spacelab-ufsc/S-band-transmitter/README.md

<h1 align="center">
	TRANSMITTER FOR S-BAND
	<br>
</h1>

<h4 align="center">Transmitter module designed to operate on S-band</h4>

<p align="center">
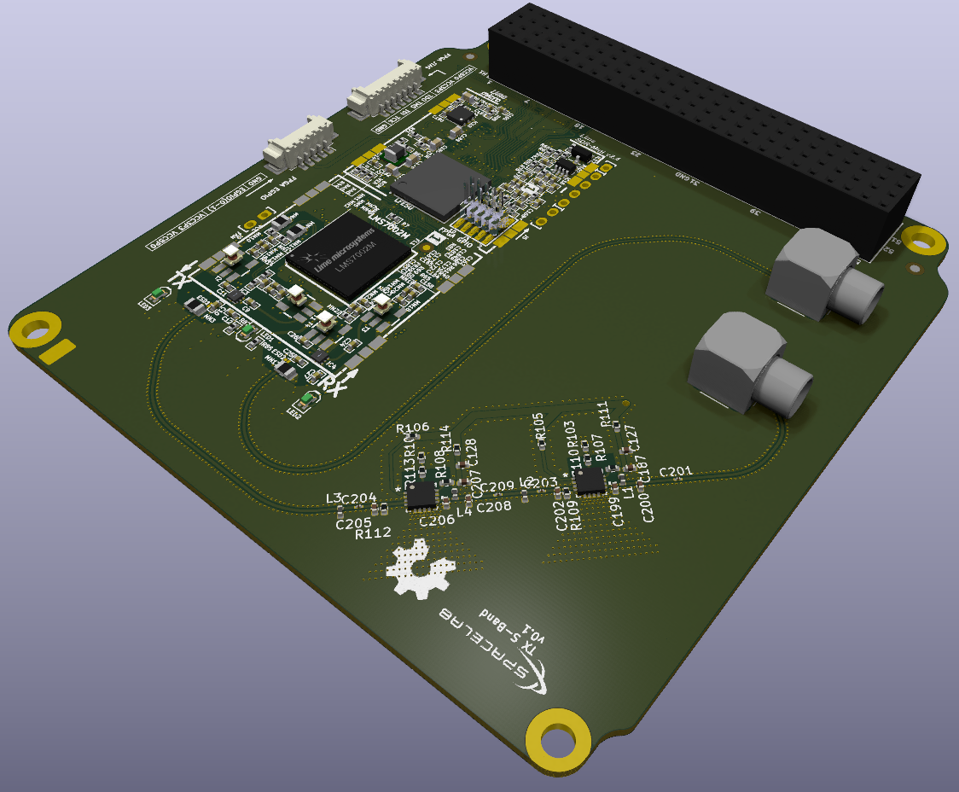
[picture p1: doc/figures/sband-board-3d-model.png]
    
</p>
