spacelab-ufsc/S-band-transmitter/hardware/sband_transmitter.kicad_pcb

## KiCad design hardware/sband_transmitter.kicad_pcb (2026-11-09)

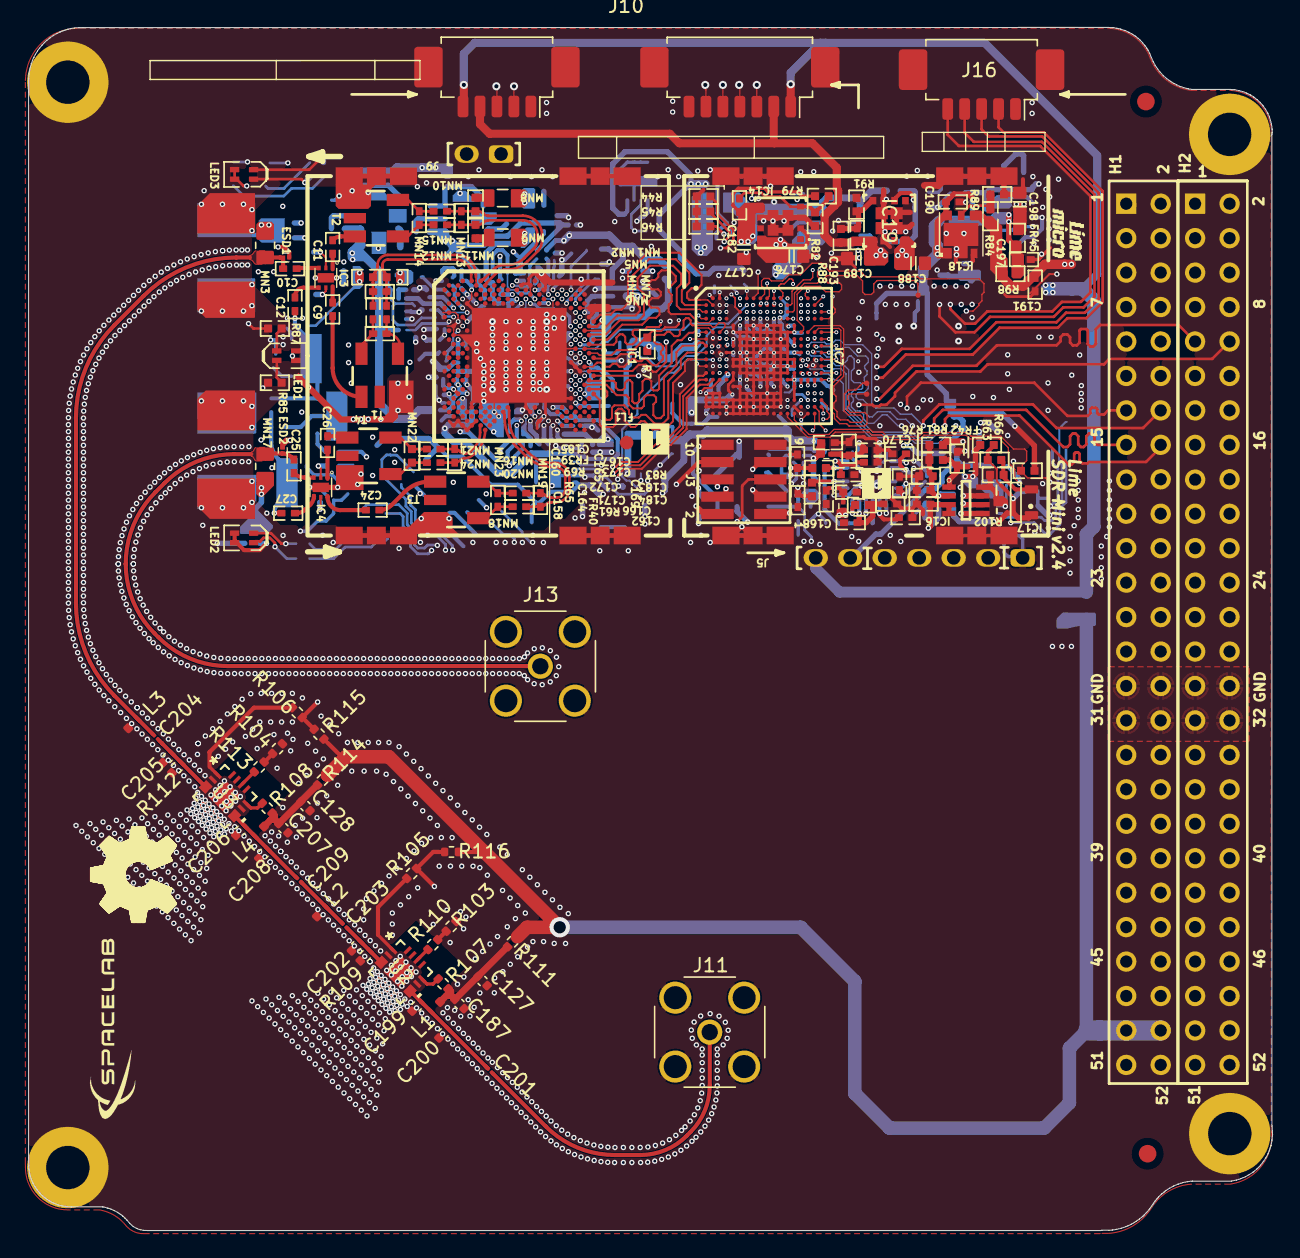
[picture p5: board sband_transmitter.kicad_pcb from above]

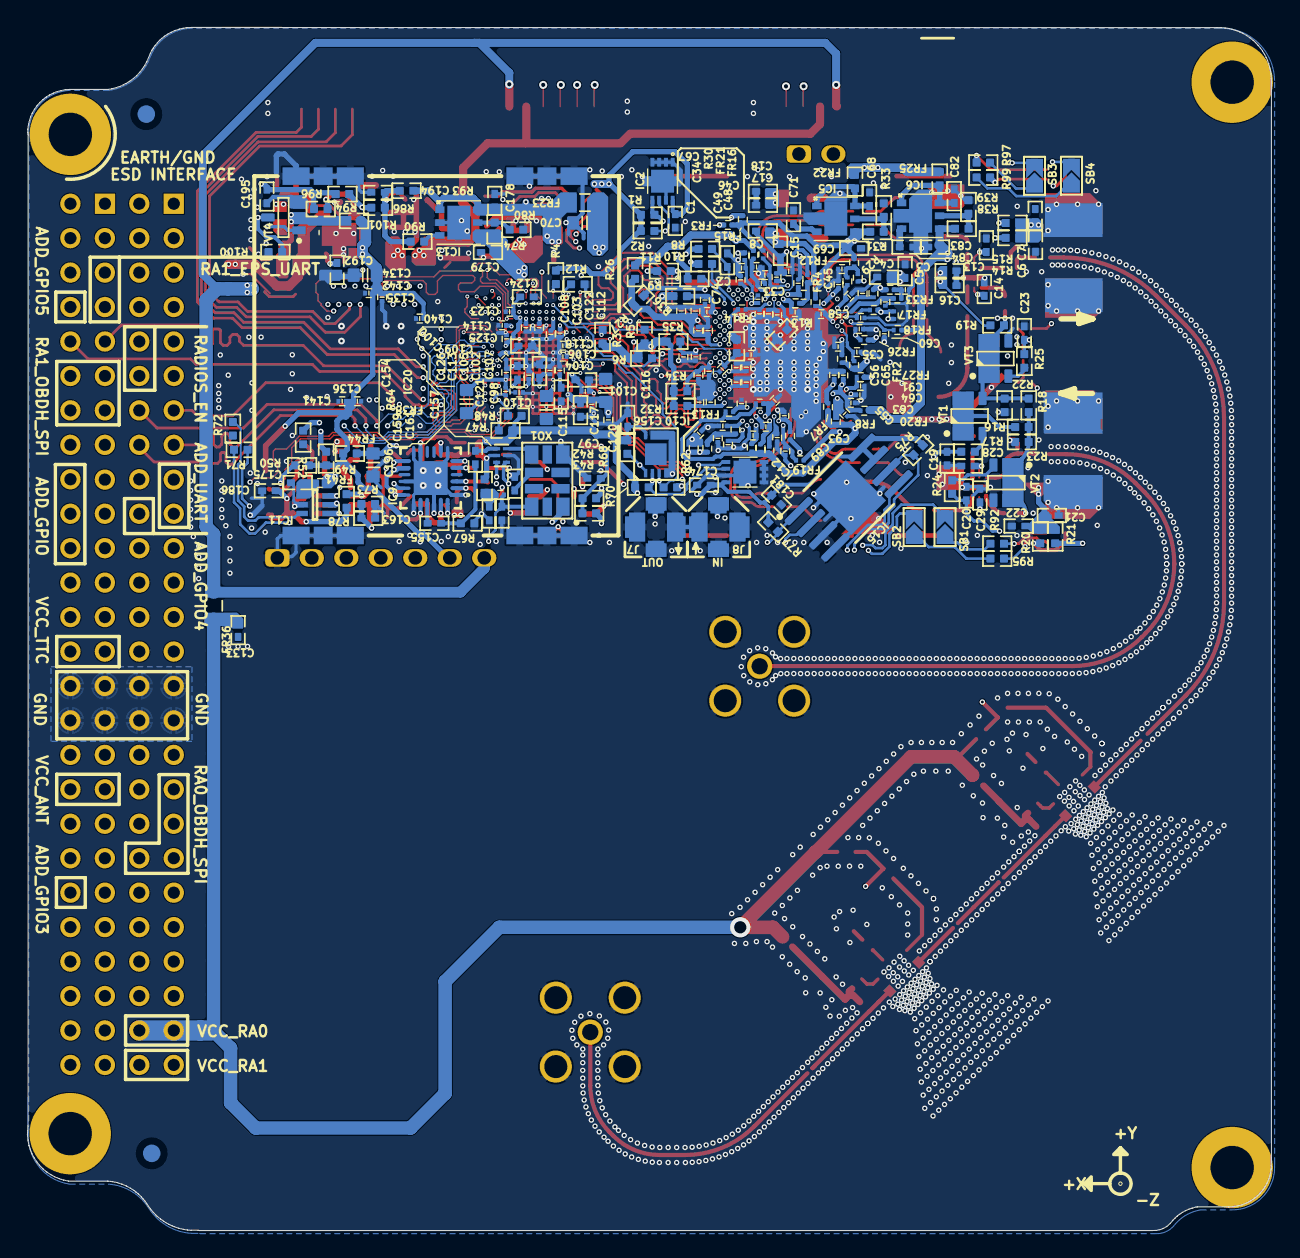
[picture p6: board sband_transmitter.kicad_pcb from below]

Board: 8 copper layers, 91.7 x 88.7 mm, 434 parts (278 on the bottom side), 218 nets.

Parts:
C1, C159, C164, C165, C194: 1uF, 25V; CAP0402
C2: 10pF, 25V; CAP0402
C3, C5, C7, C16, C17, C19, C20, C22, C23, C71, C84, C167, C168, C169, C170, C172, C173, C192: 100pF, 50V; CAP0402
C4, C6, C8, C15, C18, C21, C97, C133, C154, C155, C156, C161, C162, C163, C166, C171, C174, C175, C180, C181, C183, C185, C186, C195: 100nF, 16V; CAP0402
C9, C12, C24, C27, C158, C160: 47pF, 50V; CAP0402
C10, C11, C25, C26: 510pF; CAP0402
C13, C14, C28, C29, C102, C104, C109, C113, C115, C119, C124: 10nF, 50V; CAP0402
C30, C32, C33, C34, C35, C36, C37, C39, C41, C43, C44, C45, C46, C48, C49, C50, C51, C52, C53, C54, C55, C56, C57, C58, C59, C60, C62, C63, C64, C65, C66, C67, C73, C75, C77, C79, C81, C85, C86, C87, C88, C89, C90, C91, C92, C93, C94, C95, C96, C100, C111, C117, C122, C135, C141: 1uF, 6.3V; CAP0201
C31, C38, C40, C42, C47, C61, C72, C74, C76, C78, C80: 1nF, 10%; CAP0201
C68, C69, C82, C83, C178, C179, C190, C191, C197: 4.7uF, 6.3V; CAP0402
C70, C99, C116, C121, C134, C196, C198: 10uF, 6.3V; CAP0603
C98, C101, C103, C105, C106, C107, C108, C110, C112, C114, C118, C120, C123, C125, C126, C136, C140, C142: 100nF, 10V; CAP0201
C127, C128: 0.1uF; C_0402_1005Metric
C157: 18nF, 16V; CAP0402
C176, C177, C188, C189: 22uF, 10V; CAP0603
C182: 16pF, 50V; CAP0402
C184: 1nF, 50V; CAP0402
C187, C207: 100pF; C_0402_1005Metric
C193: 82pF, 50V; CAP0402
C199, C200, C206, C208: 1.5pF; C_0402_1005Metric
C201, C209: 27pF; C_01005_0402Metric
C202, C205: 2pF; C_0402_1005Metric
C203, C204: 1pF; C_01005_0402Metric
ESD1, ESD2: ESD8472; ESD8472_X3DFN2
FL1: Fiducial; Fiducial_local
FR1, FR2, FR3, FR4, FR5, FR6, FR7, FR8, FR9, FR10, FR11, FR12, FR13, FR14, FR15, FR16, FR17, FR18, FR19, FR20, FR21, FR24, FR26, FR27, FR28, FR29, FR30, FR31, FR32, FR33, FR34, FR38, FR39, FR40, FR41, FR42: 600R, 0.27A; RES0201
FR22, FR25, FR44, FR45: 220R, 0.9A; RES0402
FR23, FR36: 600R, 2A; RES0805
IC1: LMS7002M; LMS7002M_v5
IC2, IC12: M24128; M24128-DFMC6TG
IC3, IC4: SKY13411-374LF
IC5, IC6, IC13, IC18: LD39100PUR
IC7: LFE5U-45F-MG285; LFE5U-25F-8MG285C_LATTICE_FPGA
IC9: LMK00105; LMK00105SQ
IC10: LM75; HWSON8_LM75
IC11: DAC6311IDCK; AD5601_SOT23-6
IC14: LMZ20501SILR; LMZ20501SILR_DC-DC_8-SMD
IC15: W25Q128JVSIQ; S25FL164K_WSON8_DFN6
IC16: AD5662; AD5662_SOT23-8
IC17: AS431; SOT23-3_V3
IC19: LMZ20501SILR; SIL0008F
IC20: 74LVC1G3157FZ4; 74LVC1G3157FZ4_SPDT_SW_DFN1410-6
J3: FPGA GPIO; SWD_10_pin
J5: FPGA JTAG (board edge); HEADER7X1_TH_V2
J7, J8: U.FL/MMCX; MMCX_UFL_conn_u
J9: FAN; Header2x1_TH_v2
J10: PC104-Mainboard
J11, J13: Conn_Coaxial; CONN MCX JACK RA 50 OHM SMD
J12: FPGA JTAG (board edge); Molex_PicoBlade_53261-0771_1x07-1MP_P1.25mm_Horizontal
J15, J16: FPGA EGPIO (board edge); Molex_PicoBlade_53261-0571_1x05-1MP_P1.25mm_Horizontal
L1, L4: 18nH; L_0402_1005Metric
L2, L3: 6.2nH; L_0402_1005Metric
LED1, LED2, LED3: LED_RG; LED-2x0603
MECH2, MECH3, MECH4, MECH5, MECH6, MECH7, MECH8, MECH9, MECH11, MECH12, MECH13, MECH14: RFI Shield clip; RFI_SHIELD_CLPS_MINI
MECH10: RFI Shield; WurthElectronic_RF_shield
MECH15: RFI Shield; WURTHELECTRONIC_RF_SHIELD
MN1, MN2, MN22: 8.2nH, 5%; RES0402
MN3, MN17: 100uH; RES0805_0603
MN4, MN7: 0.8pF; CAP0402
MN5, MN13, MN19: 1pF; CAP0402
MN6, MN18: 0.5pF; CAP0402
MN8, MN9: 100uH; RES0805
MN10, MN11: 0R; RES0402
MN12, MN15: 100nF, 16V; CAP0402
MN14, MN16, MN20: 2pF; CAP0402
MN21, MN24: 510pF; CAP0402
MN23: 1.2pF; CAP0402
R1, R2: 2k2, 1%; RES0402
R3, R4, R5, R6, R7, R12, R13, R39, R62, R71, R73, R74, R77, R83, R84, R86: 10k, 1%; RES0402
R8, R9, R10, R11, R22, R23, R67: 49.9R, 1%; RES0402
R14, R15, R20, R21, R26, R27, R32, R34, R35, R36, R37, R42, R43, R44, R45, R46, R61, R65, R66, R69, R78, R90, R94, R96, R98, R100, R101, R102: 0R; RES0402
R16: 560R, 1%; RES0402
R17, R24, R25, R85, R87, R92, R95, R97, R99: 100R, 1%; RES0402
R18: 2.49k, 1%; RES0402
R19, R63, R68, R70, R75, R81: 1k, 1%; RES0402
R28, R29, R40, R41: 10R; RES0201
R30: 0R; RES0201
R31: 8.2k, 1%; RES0402
R33: 15k, 1%; RES0402
R38: 7.5k, 1%; RES0402
R47, R48, R49, R50, R51, R52, R89, R93: 4K7, 1%; RES0402
R64: 22R; RES0402
R72, R76: 3k, 1%; RES0402
R79: 80.6k, 1%; RES0402
R80: 27k, 1%; RES0402
R82: 40.2k, 1%; RES0402
R88: 237k, 1%; RES0402
R91: 52.3k, 1%; RES0402
R103, R104: 100k; R_0402_1005Metric
R105, R106: 22k; R_0402_1005Metric
R107, R108: 50R; R_0402_1005Metric
R109, R112: 15K; R_0402_1005Metric
R110, R111, R113, R114, R115, R116: 0R; R_0402_1005Metric
SB1, SB2, SB3, SB4: Solder bridge; SOLDER_BRIDGE_TRIANGULAR_V2
T1, T2, T3, T4: TC1-1-13M-45+; TC1-1-13MA+_JA4220-AL_
U2, U3: GRF5115; QFN-16_GRF
VT1, VT2, VT3: ZVN4525E6TA; ZVN4525E6_NMOS_SOT23-6
VT4: IRLML6244TRPBF; SOT23-3
XO1: E7355LF, 40MHz, w VC; RAKON_RTX5032A

Connections:
+1.8V_DIG_LMK: C164.2, C171.2, C172.2, C173.2, FR40.2, IC9.2 (Vddo), IC9.6 (Vddo)
+3.3V_DIG_LMK: C165.2, C166.2, C167.2, C168.2, C169.2, C170.2, FR39.2, IC9.8 (Vdd), IC9.14 (Vddo), IC9.18 (Vddo), IC9.23 (Vdd), R61.2
/05_LMS7002M_Misc/LMS_CORE_LDO_EN: IC1.U33 (CORE_LDO_EN), R7.1
/05_LMS7002M_Misc/LMS_I2C_SCL: IC1.C27 (SCL), IC2.6 (SCL), R2.2
/05_LMS7002M_Misc/LMS_I2C_SDA: IC1.D26 (SDA), IC2.5 (SDA), R1.2
/05_LMS7002M_Misc/LMS_RESET: IC1.E27 (RESET), R4.1
/05_LMS7002M_Misc/LMS_RXEN: IC1.V34 (RXEN), R6.2
/05_LMS7002M_Misc/LMS_TXEN: IC1.U29 (TXEN), R5.2
/05_LMS7002M_Misc/LMS_TXNRX1: IC1.V32 (TXNRX1), R3.1
/05_LMS7002M_Misc/LMS_TXNRX2: IC1.U31 (TXNRX2), R12.1
/06_LMS7002M_RF/RFSW_RX_V1: C29.2, IC4.5 (V1)
/06_LMS7002M_RF/RFSW_RX_V2: C28.2, IC4.2 (V2)
/06_LMS7002M_RF/RFSW_TX_V1: C14.2, IC3.5 (V1)
/06_LMS7002M_RF/RFSW_TX_V2: C13.2, IC3.2 (V2)
/06_LMS7002M_RF/RX: C25.2, ESD2.1, J13.1 (In), MN17.1
/06_LMS7002M_RF/RX1_H: C24.2, T3.3
/06_LMS7002M_RF/RX1_H_A_N: IC1.AJ15 (rfgn_h_RFE_1), MN19.1, MN20.2
/06_LMS7002M_RF/RX1_H_A_P: IC1.AK14 (rfgp_h_RFE_1), MN16.2, MN19.2
/06_LMS7002M_RF/RX1_H_B_N: MN18.1, MN20.1, T3.6
/06_LMS7002M_RF/RX1_H_B_P: MN16.1, MN18.2, T3.4
/06_LMS7002M_RF/RX1_W: C26.2, T4.3
/06_LMS7002M_RF/RX1_W_A_N: IC1.AP10 (rfgn_w_RFE_1), MN23.1, MN24.2
/06_LMS7002M_RF/RX1_W_A_P: IC1.AN9 (rfgp_w_RFE_1), MN21.2, MN23.2
/06_LMS7002M_RF/RX2_W_B_N: MN22.1, MN24.1, T4.6
/06_LMS7002M_RF/RX2_W_B_P: MN21.1, MN22.2, T4.4
/06_LMS7002M_RF/TX1_1: C9.2, T1.3
/06_LMS7002M_RF/TX1_1_A_N: IC1.A7 (pa1on_1), MN1.1, MN5.1, MN7.2
/06_LMS7002M_RF/TX1_1_A_P: IC1.B8 (pa1op_1), MN2.1, MN4.1, MN5.2
/06_LMS7002M_RF/TX1_1_B_N: MN6.2 (2_2), MN7.1, T1.6
/06_LMS7002M_RF/TX1_2: C11.2, T2.1
/06_LMS7002M_RF/TX2_1_A_N: IC1.B10 (pa2on_1), MN10.1, MN13.2, MN15.1
/06_LMS7002M_RF/TX2_1_A_P: IC1.A9 (pa2op_1), MN11.1, MN12.2, MN13.1
/06_LMS7002M_RF/TX2_1_B_N: MN14.1, MN15.2, T2.4
/06_LMS7002M_RF/TX2_1_B_P: MN12.1, MN14.2, T2.6
/06_LMS7002M_RF/TX_LB_AT: C19.1, R17.2
/06_LMS7002M_RF/TX_LB_SH: C20.1, C23.1, R24.1, R25.2
/08_FPGA/BOM_VER0: IC7.N1 (PR47D/LRC_GPLL0C_IN), R44.2
/08_FPGA/BOM_VER1: IC7.M1 (PR47C/LRC_GPLL0T_IN), R45.2
/08_FPGA/BOM_VER2: IC7.N2 (PR44D), R46.2
/08_FPGA/FPGA_EGPIO1: IC7.A8 (PT35B/PCLKC1_0), J15.3
/08_FPGA/FPGA_GPIO2: IC7.N16 (PB4B/D6/IO6), J3.3
/08_FPGA/FPGA_GPIO3: IC7.N17 (PB6A/D5/IO5), J3.4
/08_FPGA/FPGA_GPIO4: IC7.M18 (PB6B/D4/IO4), J3.5
/08_FPGA/FPGA_GPIO5: IC7.R18 (PB9B/D2/IO2), J3.6
/08_FPGA/FPGA_GPIO6: IC7.T17 (PB13B/CS1N), J3.7
/08_FPGA/FPGA_GPIO7: IC7.R17 (PB13A/SN/CSN), J3.8
/08_FPGA/FPGA_JTAG_TCK: IC7.U13 (TCK), J5.2, J12.6, R52.1 (1_1)
/08_FPGA/FPGA_JTAG_TDI: IC7.T13 (TDI), J5.5, J12.5, R49.2
/08_FPGA/FPGA_JTAG_TDO: IC7.V14 (TDO), J5.3, J12.3, R51.2
/08_FPGA/FPGA_JTAG_TMS: IC7.V13 (TMS), J5.4, J12.4, R50.2
/10_Misc/EN_VCC3P3: C194.2, IC19.2 (EN), R86.1, R90.2, R93.1
/10_Misc/FPGA_CFG_SPI_SCLK: IC15.6 (C), R75.1
/10_Misc/FPGA_CFG_SPI_SS: IC15.1 (S), R77.1
/10_Misc/FPGA_I2C_SCL: IC10.2 (SCL), IC12.6 (SCL), R70.2
/10_Misc/FPGA_I2C_SDA: IC10.1 (SDA), IC12.5 (SDA), R68.2
/10_Misc/FPGA_LED2_G: R92.2, SB1.1
/10_Misc/FPGA_LED2_R: R95.2, SB2.1
/10_Misc/FPGA_LED3_G: R97.2, SB3.1
/10_Misc/FPGA_LED3_R: R99.2, SB4.1
/10_Misc/FPGA_SPI_DAC_SS: IC11.1 (~SYNC), IC16.5 (~SYNC)
/10_Misc/FPGA_SPI_MOSI: IC11.3 (SDIN), IC16.7 (DIN)
/10_Misc/FPGA_SPI_SCLK: IC11.2 (SCLK), IC16.6 (SCLK)
/10_Misc/LM75_OS: IC10.3 (OS), R62.1
/10_Misc/PG_VCC1P1: IC13.3 (PG), R90.1
/10_Misc/REF_CLK_IN: IC20.1 (B1), J8.1 (X)
/10_Misc/REF_CLK_OUT: IC9.17 (CLKout4), J7.1 (X)
/10_Misc/RxPLL_CLK: C160.2, R69.1
/10_Misc/TCXO_DAC_VREF: C183.1, IC16.2 (Vref), R76.1, R78.2, R81.1, R83.1
/10_Misc/TxPLL_CLK: C158.2, R65.1
/10_Misc/XO_VC: C163.2, C184.1, IC16.3 (Vfb), IC16.4 (Vout), R71.1, R72.1, R73.1, XO1.1 (VCO)
/12_RF_Driver_PA/Driver-TX-Out: C203.1, C209.2, L2.1
Driver-Enable: IC7.N18 (PB9A/D3/IO3), J3.2, R106.1, R115.2
GND: C1.2, C2.2, C3.2, C4.1, C5.2, C6.1, C8.1, C13.1, C14.1, C15.1, C16.2, C17.2, C18.1, C19.2, C20.2, C21.1, C22.2, C23.2, C28.1, C29.1, C30.2, C31.2, C32.2, C33.2, C34.2, C35.1, C36.2, C37.2, C38.2, C39.2, C40.2, C41.2, C42.2, C43.2, C44.2, C45.2, C46.2, C47.2, C48.2, C49.1, C50.2, C51.2, C52.2, C53.2, C54.2, C55.2, C56.1, C57.2, C58.1, C59.1, C60.2, C61.2, C62.2, C63.2, C64.2, C65.2, C66.2, C67.2, C68.1, C69.1, C70.1, C71.1, C72.2, C73.2, C74.2, C75.2, C76.2, C77.2, C78.2, C79.2, C80.2, C81.2, C82.1, C83.1, C84.1, C85.2, C86.2, C87.2, C88.2, C89.2, C90.2, C91.2, C92.2, C93.2, C94.2, C95.2, C96.2, C97.1, C98.2, C99.1, C100.1, C101.2, C102.1, C103.2, C104.1, C105.2, C106.2, C107.2, C108.2, C109.1, C110.2, C111.1, C112.2, C113.1, C114.2, C115.1, C116.1, C117.1, C118.2, C119.1, C120.2, C121.1, C122.2, C123.2, C124.1, C125.2, C126.2, C127.2, C128.2, C134.1, C135.1, C136.2, C140.2, C141.1, C142.2, C156.2, C157.1, C158.1, C159.1, C160.1, C161.1, C162.1, C163.1, C164.1, C165.1, C166.1, C167.1, C168.1, C169.1, C170.1, C171.1, C172.1, C173.1, C174.2, C175.2, C176.1, C177.1, C178.1, C179.1, C180.2, C181.2, C183.2, C184.2, C185.1, C186.1, C187.2, C188.1, C189.1, C190.1, C191.1, C192.1, C194.1, C195.2, C196.1, C197.1, C198.1, C199.2, C200.2, C202.2, C205.2, C206.2, C207.2, C208.2, ESD1.2, ESD2.2, IC1.AA31 (DIGPRGND1), IC1.AF32 (DIGPRGND2), IC1.AG29 (DIGPRGND1), IC1.AJ7 (rfsn_l_RFE_2), IC1.AJ9 (rfsp_l_RFE_2), IC1.AJ19 (GND_CP_SXR), IC1.AK12 (rfsn_l_RFE_1), IC1.AK20 (GND_DIV_SXR), IC1.AL13 (rfsp_l_RFE_1), IC1.AL23 (GND_VCO_SXR), IC1.AM4 (rfgn_w_RFE_2), IC1.AM8 (rfgn_h_RFE_2), IC1.AM22 (DGND_SXR), IC1.AN3 (rfgp_w_RFE_2), IC1.AN5 (rfgp_l_RFE_2), IC1.AN7 (rfgp_h_RFE_2), IC1.AN25 (GND_RXBUF), IC1.AP6 (rfgn_l_RFE_2), IC1.B18 (DGND_CGEN), IC1.B20 (GND_CP_CGEN), IC1.C7 (GND_TLOBUF_TRF), IC1.C23 (GND_DIG), IC1.D20 (GND_DIV_CGEN), IC1.E25 (GND_SPI_BUF), IC1.F6 (GND_TXBUF), IC1.G31 (DIGPRGND2), IC1.GND (EP), IC1.H2 (GND_VCO_SXT), IC1.J33 (DIGPRGND1), IC1.K4 (GND_CP_SXT), IC1.L3 (GND_DIV_SXT), IC1.N3 (DGND_SXT), IC1.T30 (DIGPRGND1,2), IC1.V30 (LOGIC_RESET), IC1.W29 (DIGPRGND1), IC1.Y30 (DIGPRGND2), IC2.1 (E0), IC2.2 (E1), IC2.3 (E2), IC2.4 (VSS), IC2.7 (~WC), IC2.PAD, IC3.PAD, IC4.PAD, IC5.2 (GND), IC5.PAD, IC6.2 (GND), IC6.PAD, IC7.B3 (GND), IC7.E5 (GND), IC7.E7 (GND), IC7.E8 (GND), IC7.E9 (GND), IC7.E10 (GND), IC7.E11 (GND), IC7.E12 (GND), IC7.F5 (GND), IC7.F6 (GND), IC7.F7 (GND), IC7.F8 (GND), IC7.F9 (GND), IC7.F10 (GND), IC7.F11 (GND), IC7.F12 (GND), IC7.G2 (GND), IC7.G6 (GND), IC7.G7 (GND), IC7.G8 (GND), IC7.G9 (GND), IC7.G10 (GND), IC7.G11 (GND), IC7.G12 (GND), IC7.H6 (GND), IC7.H7 (GND), IC7.H8 (GND), IC7.H9 (GND), IC7.H10 (GND), IC7.H11 (GND), IC7.H12 (GND), IC7.J3 (PR29C/GR_PCLK3_1), IC7.J6 (GND), IC7.J7 (GND), IC7.J8 (GND), IC7.J9 (GND), IC7.J10 (GND), IC7.J11 (GND), IC7.J12 (GND), IC7.K5 (GND), IC7.K6 (GND), IC7.K7 (GND), IC7.K8 (GND), IC7.K9 (GND), IC7.K10 (GND), IC7.K11 (GND), IC7.L2 (GND), IC7.L5 (GND), IC7.L6 (GND), IC7.L7 (GND), IC7.L8 (GND), IC7.L9 (GND), IC7.L10 (GND), IC7.L11 (GND), IC7.L17 (GND), IC7.M6 (GND), IC7.M7 (GND), IC7.M8 (GND), IC7.M9 (GND), IC7.M10 (GND), IC7.M11 (GND), IC7.N7 (GND), IC7.N8 (GND), IC7.N9 (GND), IC7.N10 (GND), IC7.N11 (GND), IC7.P5 (GND), IC7.P6 (GND), IC7.P8 (GND), IC7.P10 (GND), IC7.P12 (GND), IC7.R1 (GND), IC7.R2 (GND), IC7.R3 (GND), IC7.R10 (GND), IC7.T1 (GND), IC7.T2 (GND), IC7.T3 (GND), IC7.T4 (GND), IC7.T5 (GND), IC7.T6 (GND), IC7.T7 (GND), IC7.T8 (GND), IC7.T9 (GND), IC7.T10 (GND), IC7.T11 (GND), IC7.T12 (GND), IC7.U1 (GND), IC7.U2 (GND), IC7.U3 (GND), IC7.U4 (GND), IC7.U5 (GND), IC7.U6 (GND), IC7.U7 (GND), IC7.U8 (GND), IC7.U9 (GND), IC7.U10 (GND), IC7.U11 (GND), IC7.U12 (GND), IC7.U14 (CFG_0), IC7.V4 (GND), IC7.V5 (GND), IC7.V6 (GND), IC7.V7 (GND), IC7.V8 (GND), IC7.V9 (GND), IC7.V10 (GND), IC7.V15 (CFG_2), IC9.1 (GND), IC9.7 (GND), IC9.11 (GND), IC9.12 (GND), IC9.16 (GND), IC9.19 (GND), IC9.22 (SEL), IC9.25 (GND), IC10.4 (GND), IC10.5 (A2), IC10.6 (A1), IC10.7 (A0), IC11.5 (GND), IC12.1 (E0), IC12.2 (E1), IC12.3 (E2), IC12.4 (VSS), IC12.7 (~WC), IC12.PAD, IC13.2 (GND), IC13.PAD, IC14.3 (MODE), IC14.6 (GND), IC14.PAD (EP_(GND)), IC15.3 (W), IC15.4 (GND), IC15.PAD (GND), IC16.8 (GND), IC17.3 (NC/A), IC18.2 (GND), IC18.PAD, IC19.3 (MODE), IC19.6 (GND), IC20.2 (GND), J3.9, J5.1, J7.2 (Y), J8.2 (Y), J10.H1-29 (Pin_29), J10.H1-30 (Pin_30), J10.H1-31 (Pin_31), J10.H1-32 (Pin_32), J10.H2-29 (Pin_29), J10.H2-30 (Pin_30), J10.H2-31 (Pin_31), J10.H2-32 (Pin_32), J11.2 (Ext), J12.7, J13.2 (Ext), J15.1, J16.1, L2.2, L3.2, MECH2.1 (GND_1), MECH3.1 (GND_1), MECH4.1 (GND_1), MECH5.1 (GND_1), MECH6.1 (GND_1), MECH7.1 (GND_1), MECH8.1 (GND_1), MECH9.1 (GND_1), MECH11.1 (GND_1), MECH12.1 (GND_1), MECH13.1 (GND_1), MECH14.1 (GND_1), R12.2, R13.2, R22.1, R23.1, R33.1, R39.1, R44.1, R45.1, R46.1, R67.1, R73.2, R80.2, R82.1, R83.2, R89.2, R91.1, R100.1, R102.2, R103.1, R104.1, R109.2, R112.2, T1.1, T2.3, T3.1, T4.1, U2.2 (GND/NC), U2.5 (GND/NC), U2.6 (GND/NC), U2.7 (GND/NC), U2.8 (GND/NC), U2.11 (GND/NC), U2.17 (GND), U3.2 (GND/NC), U3.5 (GND/NC), U3.6 (GND/NC), U3.7 (GND/NC), U3.8 (GND/NC), U3.11 (GND/NC), U3.17 (GND), VT2.4 (S), VT3.4 (S), VT4.S, XO1.4 (GND)
GPIO-1: IC7.A16 (PL20B), J16.5
GPIO-2: IC7.D18 (PL26C/PCLKT6_0), J16.4
GPIO-3: IC7.G16 (PL29D), J16.3
GPIO-4: IC7.G18 (PL32A), J16.2
I2C_SCL_DATA: IC7.K15 (PL41D), J10.H2-9 (Pin_9)
I2C_SDA_DATA: IC7.K17 (PL44A), J10.H2-10 (Pin_10)
unnamed: C6.2, C7.1 (1_1), MN3.2, R14.2, R15.2
unnamed: C21.2, C22.1, MN17.2, R20.2, R21.2
unnamed: C27.2, R16.1, R18.2, R23.2, VT2.1 (D), VT2.2 (D), VT2.5 (D), VT2.6 (D)
unnamed: C30.1, C31.1, C37.1, C38.1, C39.1, C40.1, C41.1, C42.1, IC1.AA29 (DIGPRVDD1), IC1.AE29 (DIGPRVDD1), IC1.L33 (DIGPRVDD1), IC1.R31 (DIGPRVDD1), R26.2, R27.2
unnamed: C59.2, FR12.1, R28.2, R29.2
unnamed: C74.1, C75.1, IC1.H32 (DIGPRVDD2), R36.2
unnamed: C76.1, C77.1, IC1.T32 (DIGPRVDD2), R35.2
unnamed: C78.1, C79.1, IC1.W33 (DIGPRVDD2), R34.2
unnamed: C80.1, C81.1, IC1.AH30 (DIGPRVDD2), R32.2
unnamed: C95.1, FR34.2, R41.2
unnamed: C96.1, FR33.1, R40.1
unnamed: C97.2, J3.10, R42.2, R43.2
unnamed: C127.1, C187.1, L1.1, R107.2, R111.2
unnamed: C128.1, C207.1, L4.1, R108.2, R114.2
unnamed: C154.1, C155.2, R67.2
unnamed: C159.2, FR38.1, R64.1
unnamed: C195.1, J9.2, R94.2, R96.2
unnamed: C199.1, C200.1, C201.1, L1.2, U2.9 (RF_OUT/VDD), U2.10 (RF_OUT/VDD)
unnamed: C202.1, C203.2, R109.1, U2.3 (RF_IN), U2.4 (RF_IN)
unnamed: C204.2, C205.1, R112.1, U3.3 (RF_IN), U3.4 (RF_IN)
unnamed: C206.1, C208.1, C209.1, L4.2, U3.9 (RF_OUT/VDD), U3.10 (RF_OUT/VDD)
unnamed: C2.1, IC1.C29 (SCLK), R8.1
unnamed: IC1.F30 (SDIO), R9.1
unnamed: IC1.F28 (SDO), R10.1
unnamed: IC1.D28 (SEN), R11.1
unnamed: IC1.F18 (vr_rext), R13.1
unnamed: C72.1, C73.1, IC1.W31 (DIGPRPOC), R37.2
unnamed: C88.1, FR30.1, IC1.E17 (VDD18_BIAS)
unnamed: C67.1, IC1.D24 (VDD18_DIG), R30.1
unnamed: C91.1, FR27.2, IC1.AE3 (VDD18_TIA_RFE), IC1.AF4 (VDD18_LDO_RX)
unnamed: C92.1, FR26.2, IC1.N1 (VDD18_LDO_TX)
unnamed: C93.1, FR34.1, IC1.AM26 (VDD18_RXBUF)
unnamed: C90.1, FR28.1, IC1.AM18 (VDD18_SXR)
unnamed: C87.1, FR31.1, IC1.D16 (VDD18_TRF)
unnamed: C94.1, FR33.2, IC1.H6 (VDD18_TXBUF)
unnamed: C86.1, FR32.1, IC1.E21 (VDD18_VCO_CGEN)
unnamed: C89.1, FR29.1, IC1.AK22 (VDD18_VCO_SXR)
unnamed: C85.1, FR24.1, IC1.G3 (VDD18_VCO_SXT)
unnamed: C32.1, C33.1, C34.1, FR3.1, IC1.A17 (DVDD_CGEN), IC1.C25 (VDD12_DIG), IC1.F24 (VDD_SPI_BUF)
unnamed: C36.1, FR1.1, IC1.AL21 (DVDD_SXR)
unnamed: C35.2, FR2.1, IC1.M4 (DVDD_SXT)
unnamed: C58.2, FR4.1, IC1.J5 (VDD12O_VCO_SXT), IC1.K6 (VDD12_VCO_SXT)
unnamed: C55.1, FR8.1, IC1.AG5 (VDD12_LNA_RFE)
unnamed: C51.1, IC1.AP26 (VDD12_RXBUF), R29.1
unnamed: C56.2, FR7.1, IC1.AD6 (VDD12_TIA_RFE)
unnamed: C43.1, IC1.G5 (VDD12_TXBUF), R28.1
unnamed: C52.1, FR11.1, IC1.AN23 (VDD12_VCO_SXR)
unnamed: C63.1, C64.1, C65.1, FR20.1, IC1.AD4 (VDD14_RBB), IC1.AF2 (VDD14_TIA_RFE), IC1.AF6 (VDD14_LNA_RFE)
unnamed: C61.1, C62.1, FR21.1, IC1.C21 (VDD14_VCO_CGEN)
unnamed: C60.1, FR18.1, IC1.K2 (VDDO_DIV_SXT), IC1.L5 (VDD_DIV_SXT)
unnamed: C45.1, FR17.1, IC1.D6 (VDDO_TLOBUF_TRF), IC1.F8 (VDD_TLOBUF_TRF)
unnamed: C50.1, FR13.1, IC1.AJ25 (VDD_AFE)
unnamed: C49.2, FR14.1, IC1.F20 (VDD_CP_CGEN)
unnamed: C54.1, FR9.1, IC1.AL19 (VDD_CP_SXR)
unnamed: C57.1, FR5.1, IC1.J3 (VDD_CP_SXT)
unnamed: C47.1, C48.1, FR15.1, IC1.E19 (VDD_DIV_CGEN)
unnamed: C53.1, FR10.1, IC1.AM20 (VDD_DIV_SXR)
unnamed: C66.1, FR19.1, IC1.AN17 (VDD_MXLOBUF_RFE)
unnamed: C44.1, FR6.1, IC1.P4 (VDD_TBB)
unnamed: C46.1, FR16.1, IC1.B16 (VDD_TPAD_TRF)
unnamed: C9.1, IC3.6 (ANT1)
unnamed: C11.1, IC3.1 (ANT2)
unnamed: C10.1, IC3.3 (RX)
unnamed: C12.1, IC3.4 (TX)
unnamed: C24.1, IC4.6 (ANT1)
unnamed: C26.1, IC4.1 (ANT2)
unnamed: C25.1, IC4.3 (RX)
unnamed: C27.1, IC4.4 (TX)
unnamed: IC5.5 (ADJ), R31.1, R33.2
unnamed: C68.2, FR22.2, IC5.1 (EN), IC5.6 (Vin)
unnamed: C71.2, IC5.3 (PG)
unnamed: IC6.5 (ADJ), R38.1, R39.2
unnamed: C82.2, FR25.2, IC6.1 (EN), IC6.6 (Vin)
unnamed: C84.2, IC6.3 (PG)
unnamed: IC7.V16 (INITN), R47.2
unnamed: IC7.T15 (PROGRAMN), R48.2
unnamed: C155.1, IC9.21 (CLKin)
unnamed: C162.2, IC9.20 (CLKin*)
unnamed: IC9.3 (CLKout0), R65.2
unnamed: IC9.5 (CLKout1), R69.2
unnamed: IC9.24 (OE), R61.1
unnamed: C175.1, FR41.2, IC11.4 (VDD)
unnamed: IC11.6 (VOUT), R72.2
unnamed: IC13.5 (ADJ), R74.1, R80.1
unnamed: C182.2, IC14.4 (FB), R79.1, R82.2
unnamed: C180.1, FR42.2, IC16.1 (Vdd), R76.2
unnamed: IC17.2 (A), R66.2, R102.1
unnamed: IC18.5 (ADJ), R84.1, R89.1
unnamed: C192.2, IC18.3 (PG)
unnamed: C193.2, IC19.4 (FB), R88.1, R91.2
unnamed: C154.2, IC20.4 (A)
unnamed: IC20.3 (B0), XO1.6 (RF_OUT)
unnamed: J9.1, R100.2, VT4.D
unnamed: C201.2, J11.1 (In)
unnamed: LED1.3, R85.1
unnamed: LED1.4, R87.1
unnamed: LED2.3, R92.1
unnamed: LED2.4, R95.1
unnamed: LED3.3, R97.1
unnamed: LED3.4, R99.1
unnamed: MN8.1, MN10.2
unnamed: MN9.1, MN11.2
unnamed: R16.2, VT1.1 (D), VT1.2 (D), VT1.5 (D), VT1.6 (D)
unnamed: R103.2, R110.1
unnamed: R104.2, R113.1
unnamed: R110.2, U2.14 (BIAS1)
unnamed: R107.1, U2.12 (BIAS2)
unnamed: R105.2, U2.1 (VENABLE)
unnamed: R113.2, U3.14 (BIAS1)
unnamed: R108.1, U3.12 (BIAS2)
unnamed: R106.2, U3.1 (VENABLE)
unnamed: R17.1, VT1.3 (G)
unnamed: C12.2, R18.1, R19.1, R22.2, VT1.4 (S), VT3.1 (D), VT3.2 (D), VT3.5 (D), VT3.6 (D)
unnamed: R24.2, VT2.3 (G)
unnamed: R25.1, VT3.3 (G)
unnamed: C157.2, XO1.7 (VC_FILTER)
PA-Enable: IC7.N15 (PB4A/D7/IO7), J3.1, R105.1, R116.2
SPI_CS_N/SS_N_DATA: IC7.L16 (PL44D), J10.H1-16 (Pin_16)
SPI_MISO_DATA: IC7.J16 (PL35D), J10.H1-15 (Pin_15)
SPI_MOSI_DATA: IC7.H16 (PL35C), J10.H1-14 (Pin_14)
SPI_SCK_DATA: IC7.K16 (PL41C), J10.H1-13 (Pin_13)
TX: C10.2, C204.1, ESD1.1, L3.1, MN3.1
VCC1P1: C99.2, C100.2, C101.1, C102.2, C103.1, C104.2, C105.1, C106.1, C107.1, C108.1, C109.2, C179.2, IC7.D8 (VCC), IC7.D9 (VCC), IC7.D10 (VCC), IC7.D11 (VCC), IC7.J4 (VCC), IC7.J5 (VCC), IC7.J14 (VCC), IC7.J15 (VCC), IC7.M4 (VCC), IC7.M15 (VCC), IC7.P7 (VCC), IC7.P9 (VCC), IC7.P11 (VCC), IC13.4 (Vout), R74.2
VCC1P4_LMS: C83.2, FR18.2, FR19.2, FR20.2, FR21.2, IC6.4 (Vout), R26.1, R38.2
VCC1P8: C177.2, C178.2, C182.1, FR23.1, FR40.1, IC13.1 (EN), IC13.6 (Vin), IC14.5 (VOUT), R62.2, R79.2, R93.2
VCC1P8_LMS: C3.1, C4.2, C5.1, C8.2, C15.2, C16.1, C17.1, C18.2, C70.2, FR22.1, FR23.2, FR24.2, FR25.1, FR26.1, FR27.1, FR28.2, FR29.2, FR30.2, FR31.2, FR32.2, MN1.2, MN2.2, MN8.2, MN9.2, R19.2, R30.2, R40.2, R41.1
VCC1P25_LMS: C69.2, FR1.2, FR2.2, FR3.2, FR4.2, FR5.2, FR6.2, FR7.2, FR8.2, FR9.2, FR10.2, FR11.2, FR12.2, FR13.2, FR14.2, FR15.2, FR16.2, FR17.2, IC5.4 (Vout), R27.1, R31.2
VCC2P5: C111.2, C112.1, C113.2, C114.1, C115.2, C191.2, IC7.E6 (VCCAUX), IC7.E13 (VCCAUX), IC7.N6 (VCCAUX), IC7.P13 (VCCAUX), IC18.4 (Vout), R81.2, R84.2, R98.1
VCC2P5_VREF: C186.2, IC17.1 (K), R63.1, R66.1, R78.1
VCC3P3: C98.1, C110.1, C121.2, C122.1, C123.1, C124.2, C125.1, C126.1, C134.2, C135.2, C136.1, C140.1, C141.2, C142.1, C156.1, C174.1, C181.1, C189.2, C190.2, C193.1, FR44.1, IC7.D7 (VCCIO1), IC7.D12 (VCCIO0), IC7.G14 (VCCIO7), IC7.H14 (VCCIO7), IC7.M14 (VCCIO6), IC7.N13 (VCCIO8), IC7.N14 (VCCIO6), IC7.P14 (VCCIO8), IC7.T14 (CFG_1), IC10.8 (VCC), IC12.8 (VCC), IC15.7 (HOLD), IC15.8 (VCC), IC18.1 (EN), IC18.6 (Vin), IC19.5 (VOUT), J5.6, J12.2, J15.4, LED1.1, LED1.2, LED2.1, LED2.2, LED3.1, LED3.2, R14.1, R20.1, R42.1, R47.1, R48.1, R49.1, R50.1, R51.1, R68.1, R70.1, R75.2, R77.2, R88.2, R96.1, R101.1
VCC3P3_CLK: C185.2, C196.2, FR39.1, FR41.1, FR42.1, FR44.2, IC20.5 (VCC), R63.2, R64.2
VCC3P3_XO: C161.2, FR38.2, R71.2, XO1.9 (VCC)
VCC5P0: C176.2, C188.2, FR36.2, IC14.2 (EN), IC14.8 (VIN), IC19.8 (VIN), J5.7, J12.1, J15.5, R15.1, R21.1, R43.1, R86.2, R94.1
VCC_3V3: J10.H2-27 (Pin_27), J10.H2-28 (Pin_28)
VCC_3V3_ANT: J10.H2-35 (Pin_35), J10.H2-36 (Pin_36)
VCC_5V_RA_0: C133.1 (1_1), FR36.1, J10.H1-49 (Pin_49), J10.H1-50 (Pin_50), R111.1, R114.1, R115.1, R116.1
VCC_6V_RA_1: J10.H1-51 (Pin_51), J10.H1-52 (Pin_52)
VDIO_LMS: C1.1, C198.2, FR45.2, IC2.8 (VCC), R1.1, R2.1, R3.2, R4.2, R5.1, R6.1, R7.2, R32.1, R34.1, R35.1, R36.1, R37.1
VDIO_LMS_FPGA: C116.2, C117.2, C118.1, C119.2, C120.1, C197.2, FR45.1, IC7.G5 (VCCIO2), IC7.H5 (VCCIO2), IC7.M5 (VCCIO3), IC7.N5 (VCCIO3), R98.2, R101.2
