spacelab-ufsc/S-band-transmitter/(commit log)

2026-09-15 Linking schematics components to PCB
    [05_LMS7002M_Misc.kicad_sch, 06_LMS7002M_RF.kicad_sch, 07_LMS7002M_Power.kicad_sch, 08_FPGA.kicad_sch, 09_USB3_0_FIFO.kicad_sch, 10_Misc.kicad_sch, 11_pc104.kicad_sch, 12-rf_driver_pa.kicad_sch]
2026-09-16 Updated sheet names, added s-band initial block diagram
    [03_clock_diagram_(page_4).kicad_sch, 11_pc104.kicad_sch, 12-rf_driver_pa.kicad_sch, sband_transmitter.kicad_sch]
2026-09-21 Added RF Tools plugin for KiCAD v10, rerouted FPGA JTAG and FPGA EGPIO connectors and tracks, rerouted VCC5P0 track, added via fence around RF tracks.
    [12-rf_driver_pa.kicad_sch, sband_transmitter.kicad_pcb]
2026-09-30 Added RF vias, improved RF tracks, changed FPGA board edge connectors to pico-blade, added data input connections for SPI and I2C protocols, added extra tracks for auxiliary board edge connector, fix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
2026-11-06 Added GPIO on board edge, changed RX connector placement on the board, added FPGA traces to control the Driver/PA enable signals, and other minor changes.
2026-11-09 Added missing footprints, checked the errors in DRC all warning and errors seems to be related to lack of KiCad capability to fully import the Altium PCB design rules.
