spacelab-ufsc/S-band-transmitter/(notices)

Notices in the files:
firmware/main.c:
This is free software: you can redistribute it and/or modify
it under the terms of the GNU General Public License as published by
the Free Software Foundation, either version 3 of the License, or
(at your option) any later version.
firmware/README.md:
License: GPL3
